jsteinka05-ui/ECE362-Mini-Project-Gamer-Console/hardware/production/rev1.2/Gamers_rev1.2_bom.csv

Designator | Footprint | Quantity | Value | LCSC Part #
C1, C5 | 0805 | 2 | 100nF | C49678
C10, C9 | 1206 | 2 | 22uF | C12891
C11, C4 | 0805 | 2 | 1uF | C28323
C2, C8 | 1206 | 2 | 10uF | C13585
C3 | 0805 | 1 | 10nF | C1710
C6 | 0805 | 1 | 47nF | C53134
C7 | CP_Elec_6.3x7.7 | 1 | Polarized_220uF | C2827940
L1 | L_Sunlord_MWSA0402S | 1 | 1uH | C408332
R1, R2 | 0805 | 2 | 4.7K | C17673
R3 | 0805 | 1 | 330k | C17629
R4 | 1206 | 1 | 10 | C17903
R5 | 0805 | 1 | 732k | C17816
R6, R7 | 0805 | 2 | 100k | C17407
U2 | SOT-363_SC-70-6 | 1 | LM66100DCK | C2869734
U3 | SOT-563 | 1 | TPS61023DRLR | C919459
