jsteinka05-ui/ECE362-Mini-Project-Gamer-Console/hardware/kicad/ECE362 MINI Proj.kicad_pcb

## KiCad design hardware/kicad/ECE362 MINI Proj.kicad_pcb (2026-11-09)

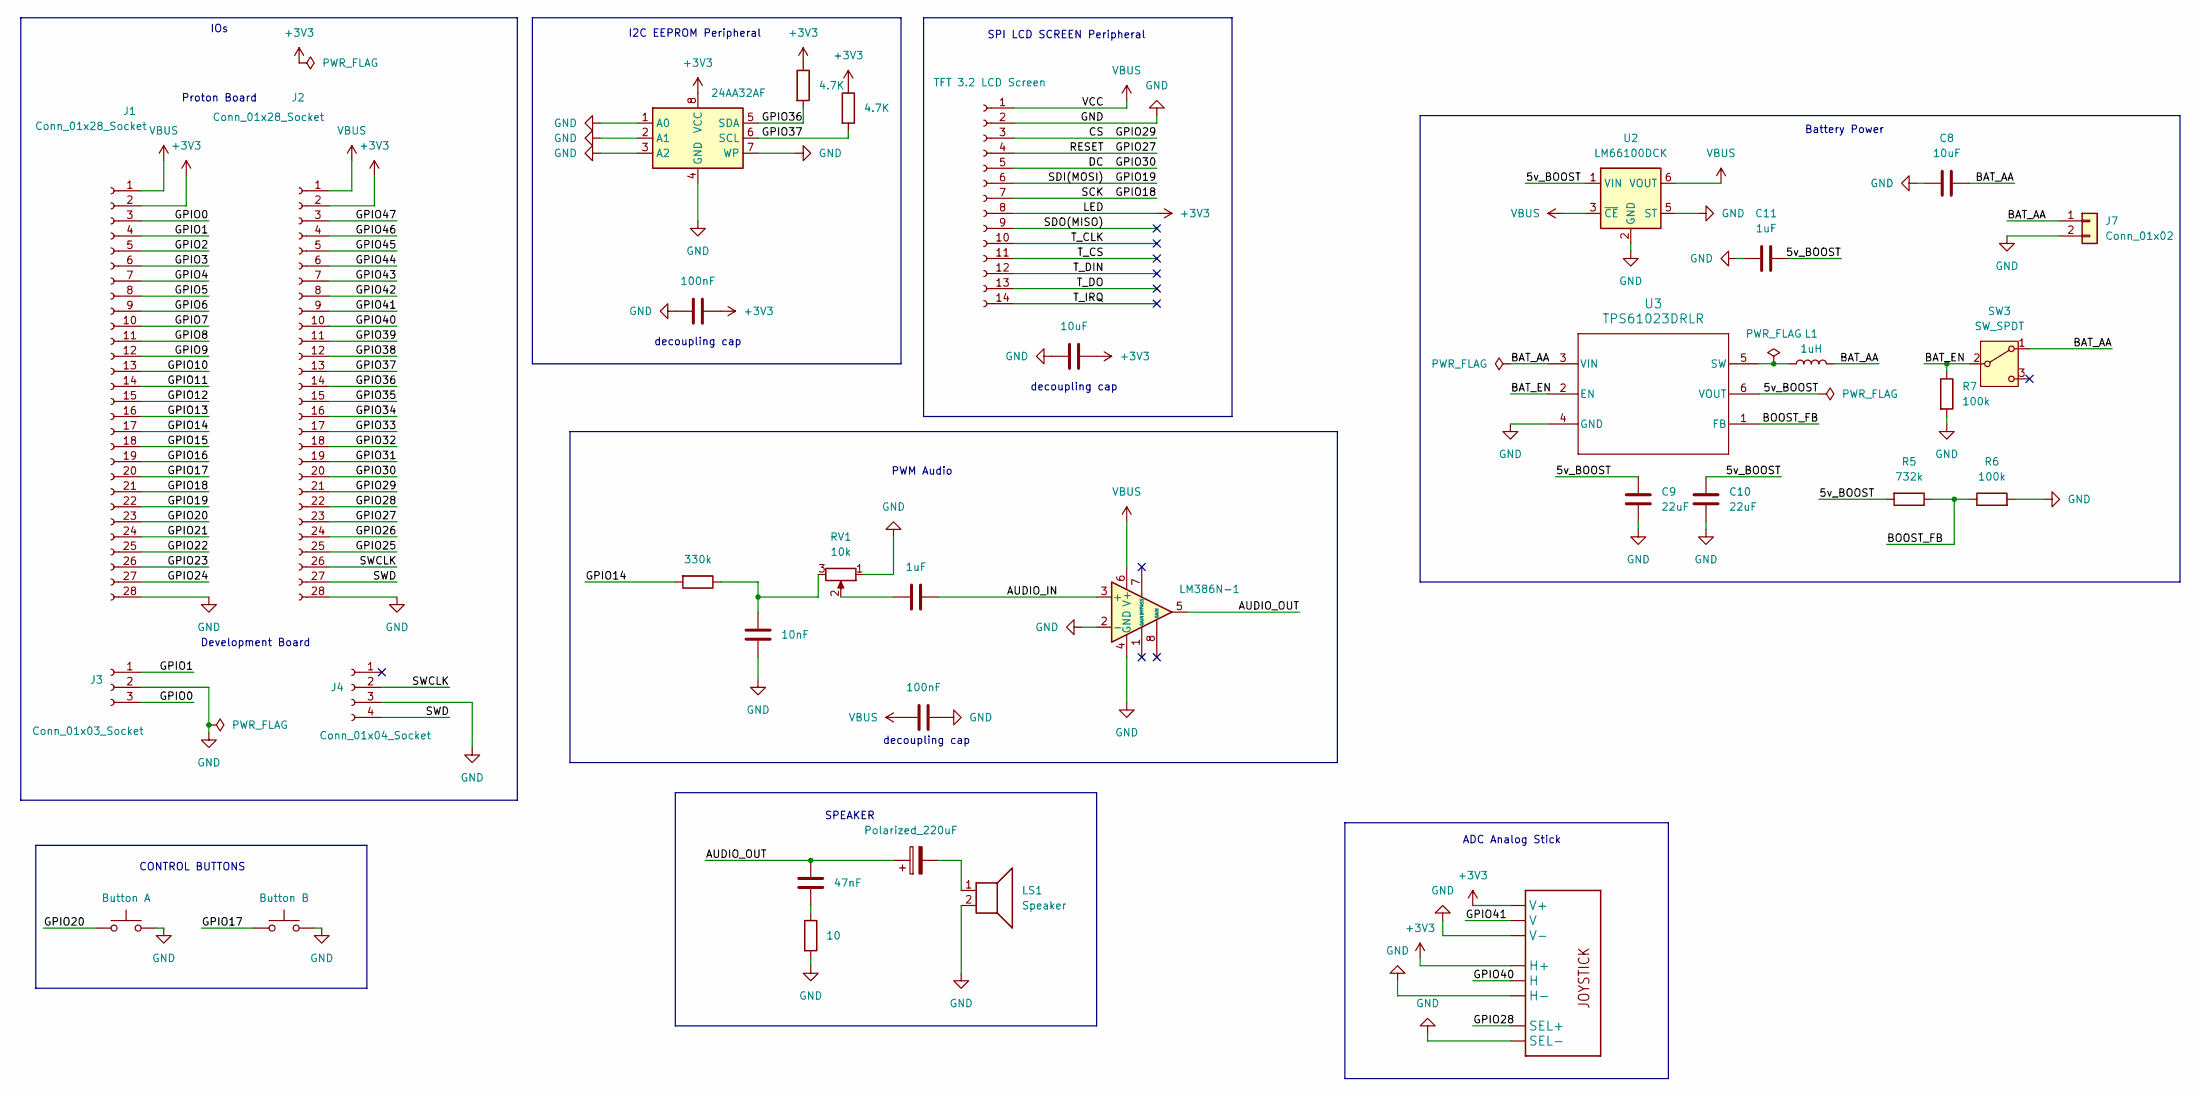
[picture p2: schematic ECE362 MINI Proj.kicad_sch]

Parts:
C1, C5: 100nF; C_0805_2012Metric; LCSC Part # C49678
C2, C8: 10uF; C_1206_3216Metric; LCSC Part # C13585
C3: 10nF; C_0805_2012Metric; LCSC Part # C1710
C4, C11: 1uF; C_0805_2012Metric; LCSC Part # C28323
C6: 47nF; C_0805_2012Metric; LCSC Part # C53134
C7: Polarized_220uF; CP_Elec_6.3x7.7; LCSC Part # C2827940
C9, C10: 22uF; C_1206_3216Metric; LCSC Part # C12891
J1, J2: Conn_01x28_Socket; PinSocket_1x28_P2.54mm_Vertical
J3: Conn_01x03_Socket; PinSocket_1x03_P2.54mm_Vertical
J4: Conn_01x04_Socket; PinSocket_1x04_P2.54mm_Vertical
J5: TFT 3.2 LCD Screen; PinSocket_1x14_P2.54mm_Vertical
J7: Conn_01x02; TerminalBlock_Phoenix_MKDS-1,5-2-5.08_1x02_P5.08mm_Horizont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
L1: 1uH; L_Sunlord_MWSA0402S; LCSC Part # C408332
LS1: Speaker; Speaker_Adafruit1898_D29.3_P15
R1, R2: 4.7K; R_0805_2012Metric; LCSC Part # C17673
R3: 330k; R_0805_2012Metric; LCSC Part # C17629
R4: 10; R_1206_3216Metric; LCSC Part # C17903
R5: 732k; R_0805_2012Metric; LCSC Part # C17816
R6, R7: 100k; R_0805_2012Metric; LCSC Part # C17407
RV1: 10k; Potentiometer_Adafruit4271
SW1: Button A; SW_SPST_Omron_B3F-40xx
SW2: Button B; SW_SPST_Omron_B3F-40xx
SW3: SW_SPDT; PinHeader_1x03_P2.54mm_Vertical
U1: LM386N-1; DIP-8_W7.62mm
U2: LM66100DCK; SOT-363_SC-70-6; LCSC Part # C2869734
U3: TPS61023DRLR; SOT-563; LCSC Part # C919459
U4: JOYSTICKPTH; JOYSTICK_ADAFRUIT512
U7: 24AA32AF; DIP-8_W7.62mm

Connections:
+3V3: C1.1, C2.1, J1.2, J2.2, J5.8, R1.1, R2.1, U4.H1 (H+), U4.V1 (V+), U7.8 (VCC)
/5v_BOOST: C9.1, C10.1, C11.2, R5.2, U2.1 (VIN), U3.6 (VOUT)
/AUDIO_IN: C4.2, U1.3 (+)
/AUDIO_OUT: C6.1, C7.1, U1.5
/BAT_AA: C8.2, J7.1, L1.2, SW3.1 (A), U3.3 (VIN)
/BAT_EN: R7.1, SW3.2 (B), U3.2 (EN)
/BOOST_FB: R5.1, R6.1, U3.1 (FB)
/CS: J2.21, J5.3
/DC: J2.20, J5.5
/GPIO0: J1.3, J3.3
/GPIO1: J1.4, J3.1
/GPIO2: J1.5
/GPIO3: J1.6
/GPIO4: J1.7
/GPIO5: J1.8
/GPIO6: J1.9
/GPIO7: J1.10
/GPIO8: J1.11
/GPIO9: J1.12
/GPIO10: J1.13
/GPIO11: J1.14
/GPIO12: J1.15
/GPIO13: J1.16
/GPIO14: J1.17, R3.2
/GPIO15: J1.18
/GPIO16: J1.19
/GPIO17: J1.20, SW2.1
/GPIO18: J1.21, J5.7
/GPIO19: J1.22, J5.6
/GPIO20: J1.23, SW1.1
/GPIO21: J1.24
/GPIO22: J1.25
/GPIO23: J1.26
/GPIO24: J1.27
/GPIO25: J2.25
/GPIO26: J2.24
/GPIO27: J2.23, J5.4
/GPIO28: J2.22, U4.B1A (SEL+)
/GPIO31: J2.19
/GPIO32: J2.18
/GPIO33: J2.17
/GPIO34: J2.16
/GPIO35: J2.15
/GPIO36: J2.14, R2.2, U7.5 (SDA)
/GPIO37: J2.13, R1.2, U7.6 (SCL)
/GPIO38: J2.12
/GPIO39: J2.11
/GPIO40: J2.10, U4.H2 (H)
/GPIO41: J2.9, U4.V2 (V)
/GPIO42: J2.8
/GPIO43: J2.7
/GPIO44: J2.6
/GPIO45: J2.5
/GPIO46: J2.4
/GPIO47: J2.3
/SDO(MISO): J5.9
/SWCLK: J2.26, J4.2
/SWD: J2.27, J4.4
/T_CLK: J5.10
/T_CS: J5.11
/T_DIN: J5.12
/T_DO: J5.13
/T_IRQ: J5.14
GND: C1.2, C2.2, C3.2, C5.2, C8.1, C9.2, C10.2, C11.1, J1.28, J2.28, J3.2, J4.3, J5.2, J7.2, LS1.2, R4.2, R6.2, R7.2, RV1.1, SW1.2, SW2.2, U1.2 (-), U1.4 (GND), U2.2 (GND), U2.5 (ST), U3.4 (GND), U4.B2A (SEL-), U4.H3 (H-), U4.V3 (V-), U7.1 (A0), U7.2 (A1), U7.3 (A2), U7.4 (GND), U7.7 (WP)
unnamed: C3.1, R3.1, RV1.3
unnamed: C4.1, RV1.2
unnamed: C6.2, R4.1
unnamed: C7.2, LS1.1
unnamed: L1.1, U3.5 (SW)
VBUS: C5.1, J1.1, J2.1, J5.1, U1.6 (V+), U2.3 (~CE), U2.6 (VOUT)

Notes on the sheet:
PWM Audio
SPEAKER
decoupling cap
IOs
SPI LCD SCREEN Peripheral
Battery Power
Proton Board
Development Board
I2C EEPROM Peripheral
CONTROL BUTTONS
ADC Analog Stick

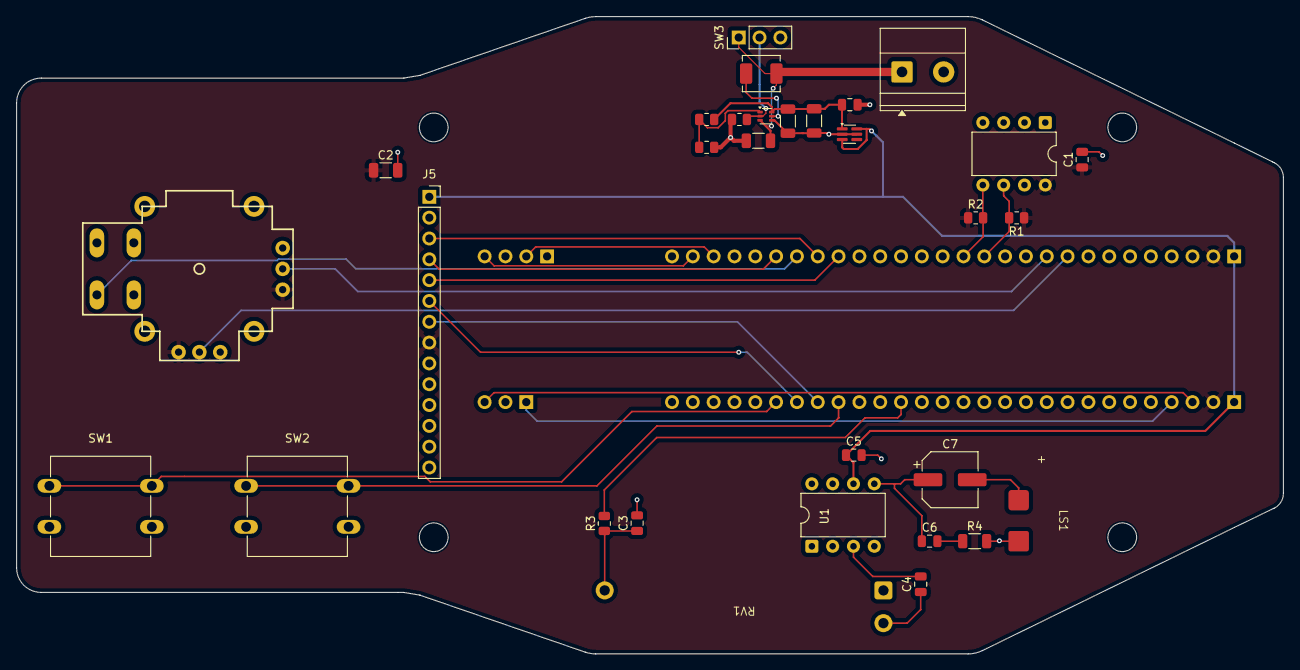
[picture p3: board ECE362 MINI Proj.kicad_pcb from above]

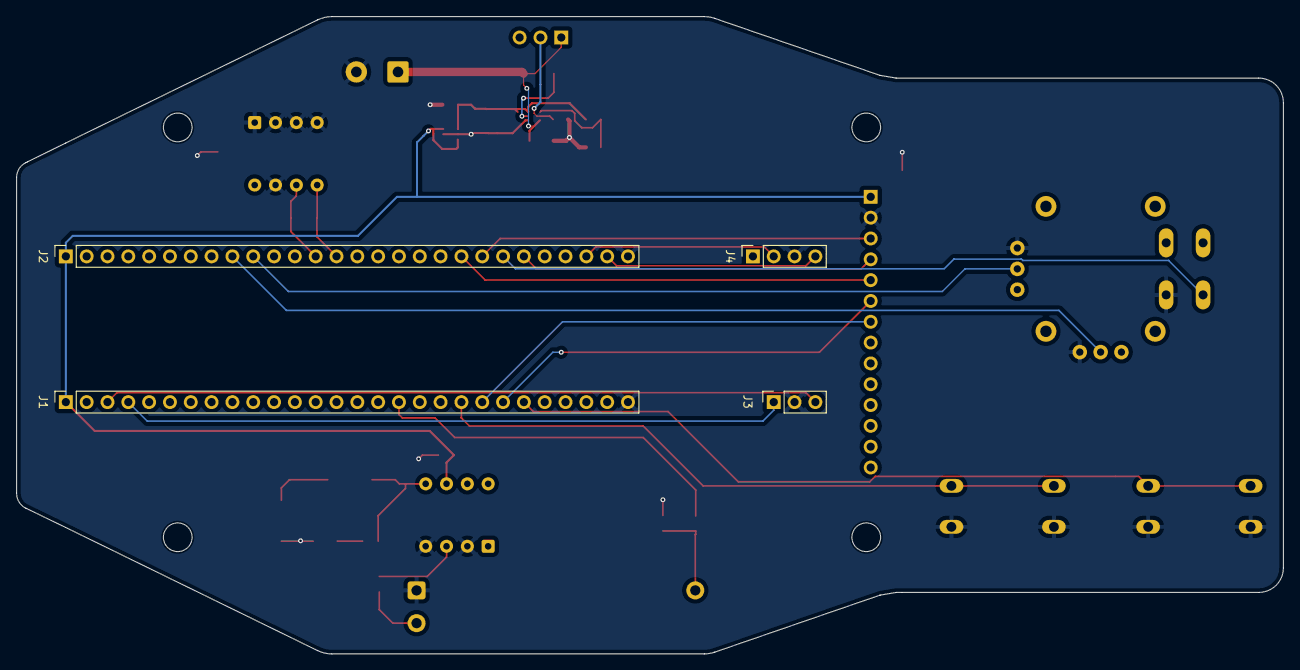
[picture p4: board ECE362 MINI Proj.kicad_pcb from below]

Board: 2 copper layers, 154.5 x 77.8 mm, 35 parts (4 on the bottom side), 31 nets.
