jsteinka05-ui/ECE362-Mini-Project-Gamer-Console/include/lcd_spi.h

#ifndef LCD_SPI_H
#define LCD_SPI_H

#define PIN_SDI    19
#define PIN_CS     17
#define PIN_SCK    18
#define PIN_DC     20
#define PIN_nRESET 27

void lcd_spi_init(void);

#endif
