jsteinka05-ui/ECE362-Mini-Project-Gamer-Console/src/lcd_spi.c

#include "pico/stdlib.h"
#include "hardware/spi.h"
#include "lcd_spi.h"

void lcd_spi_init(void) {
    gpio_set_function(PIN_CS, GPIO_FUNC_SIO);
    gpio_set_function(PIN_DC, GPIO_FUNC_SIO);
    gpio_set_function(PIN_nRESET, GPIO_FUNC_SIO);

    gpio_set_dir(PIN_CS, GPIO_OUT);
    gpio_set_dir(PIN_DC, GPIO_OUT);
    gpio_set_dir(PIN_nRESET, GPIO_OUT);

    gpio_put(PIN_CS, 1);
    gpio_put(PIN_DC, 0);
    gpio_put(PIN_nRESET, 1);

    gpio_set_function(PIN_SCK, GPIO_FUNC_SPI);
    gpio_set_function(PIN_SDI, GPIO_FUNC_SPI);

    spi_init(spi0, 12 * 1000 * 1000);
    spi_set_format(spi0, 8, SPI_CPOL_0, SPI_CPHA_0, SPI_MSB_FIRST);
}
