jsteinka05-ui/ECE362-Mini-Project-Gamer-Console/(commit log)

2026-10-25 aditya lcd/spi initial commit
2026-10-25 Add SPI TFT LCD starter code
2026-10-25 Implement Cup Pong LCD graphics and SPI setup
2026-10-26 Added KiCad Schematic
    [ECE362 MINI Proj.kicad_sch]
2026-10-28 KiCad Zip Project File
2026-10-29 Delete ECE362 MINI Proj.zip
    Updating PCB Layout
2026-10-29 Updated KiCad PCB Layout
2026-10-29 adc final changes to aim
2026-11-02 Kicad Project File Zip
2026-11-02 Delete ECE362 MINI Proj.zip
    Replacing With updated kicad project
2026-11-02 Zip File of Kicad Project, PCB layout v1
2026-11-04 PCB - BOM, positions, GERBERS
    [Gamers_rev1.1_bom.csv, Gamers_rev1.1_designators.csv, Gamers_rev1.1_positions.csv]
2026-11-04 Kicad Project File 1.4
2026-11-09 Add rev 1.2 hardware design and manufacturing files
    [ECE362 MINI Proj.kicad_pcb, ECE362 MINI Proj.kicad_sch, Gamers_rev1.2_bom.csv, Gamers_rev1.2_positions.csv]
2026-11-11 implemented pwm, along with test program
2026-11-12 Integrate Cup Pong gameplay with SPI DMA, joystick, and PWM audio
